adstdevlopment/Robot_Control_Board/Pictures/I2C pull-up resistor formula.PNG

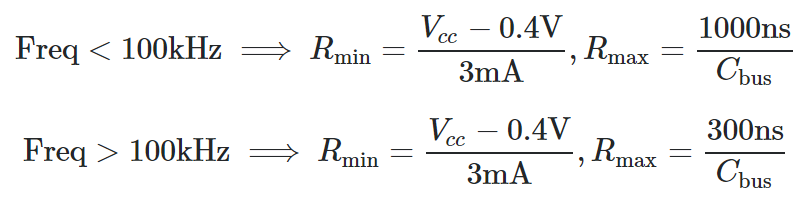
Pictures/I2C pull-up resistor formula.PNG
