adstdevlopment/Robot_Control_Board/Pictures/Impedance calculation USB.PNG

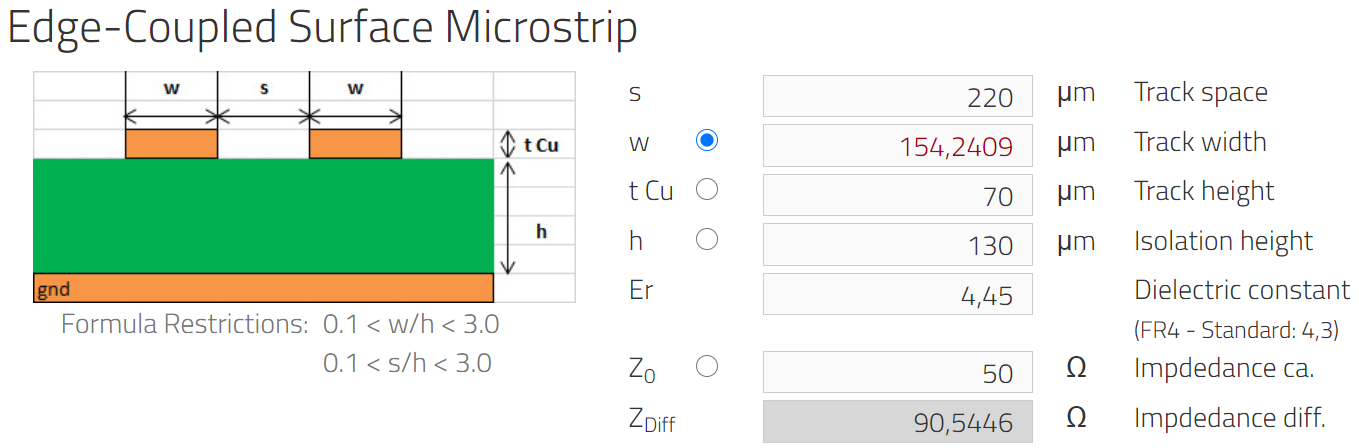
Pictures/Impedance calculation USB.PNG
