adstdevlopment/Robot_Control_Board/Pictures/Layers manager.PNG

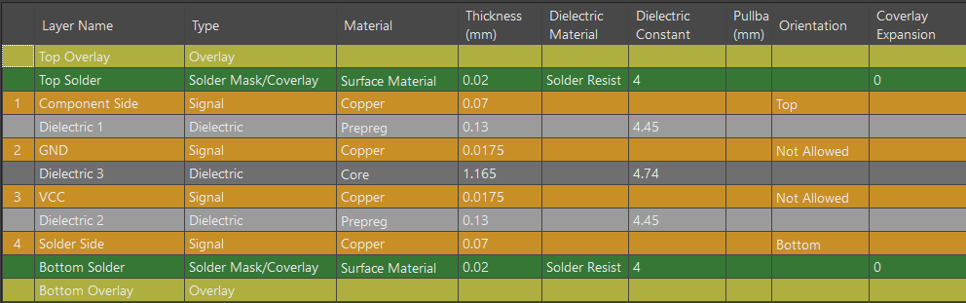
Pictures/Layers manager.PNG
