adstdevlopment/Robot_Control_Board/Pictures/PCB 4 layers sgn1_gnd_vcc_sgn2.PNG

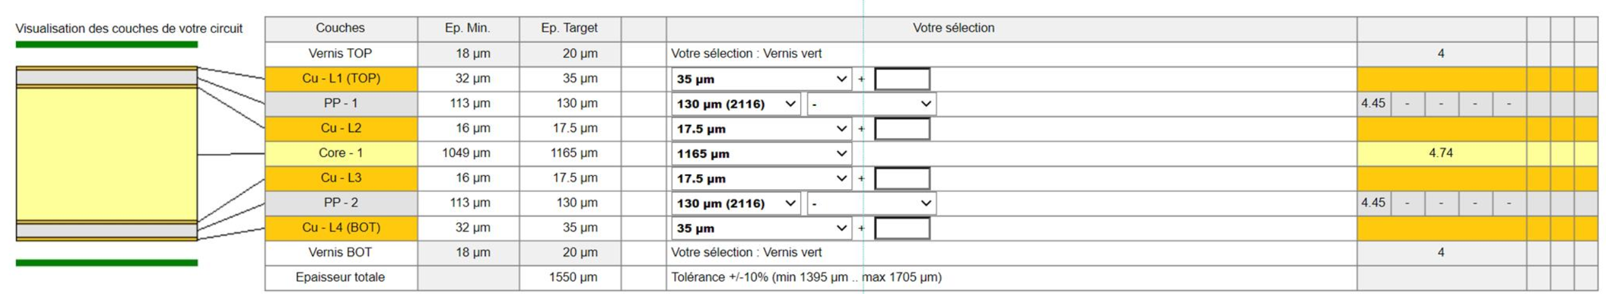
Pictures/PCB 4 layers sgn1_gnd_vcc_sgn2.PNG
