adstdevlopment/Robot_Control_Board/Pictures/Summary Table of the calculated values around shunt resistors.PNG

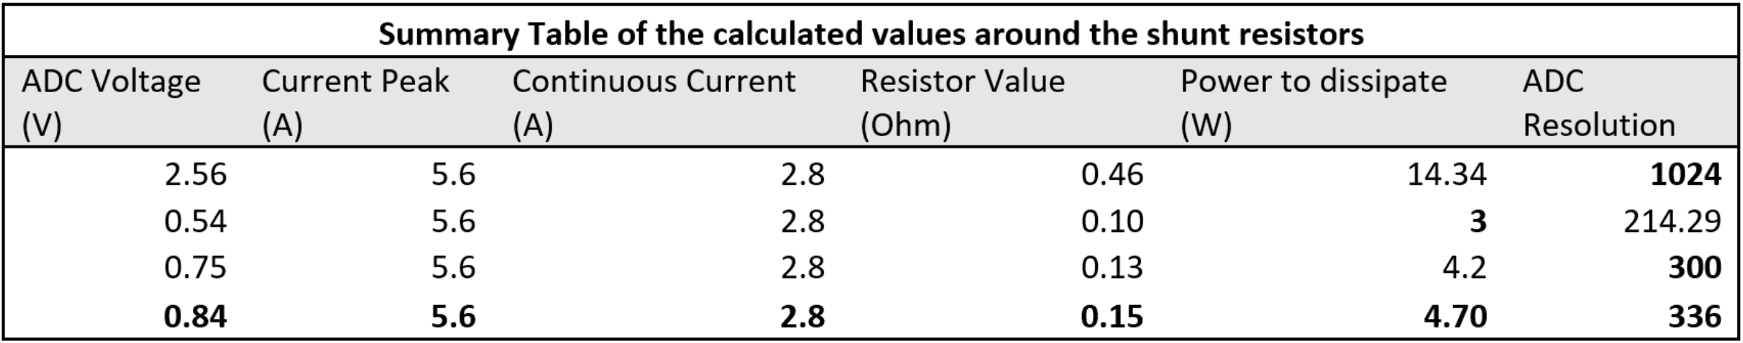
Pictures/Summary Table of the calculated values around shunt resistors.PNG
