adstdevlopment/Robot_Control_Board/Pictures/Truth table H-bridge.PNG

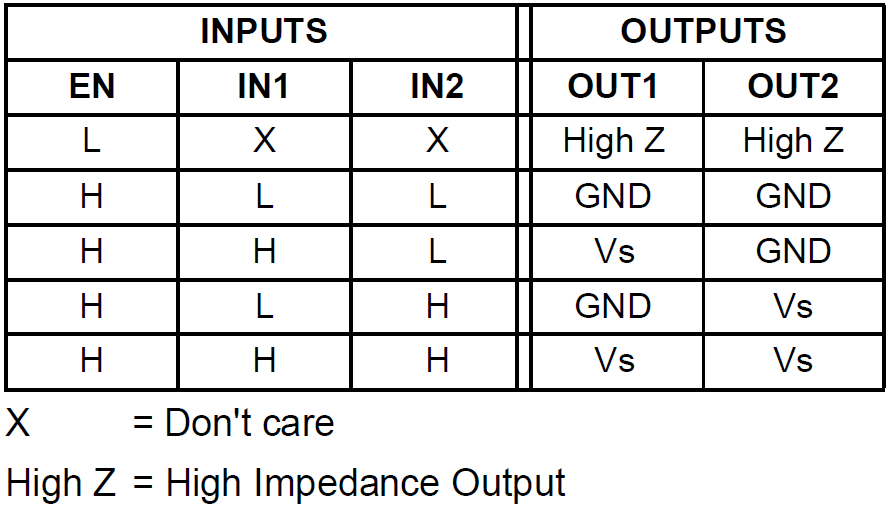
Pictures/Truth table H-bridge.PNG
