adstdevlopment/Robot_Control_Board/Pictures/VCC plan.PNG

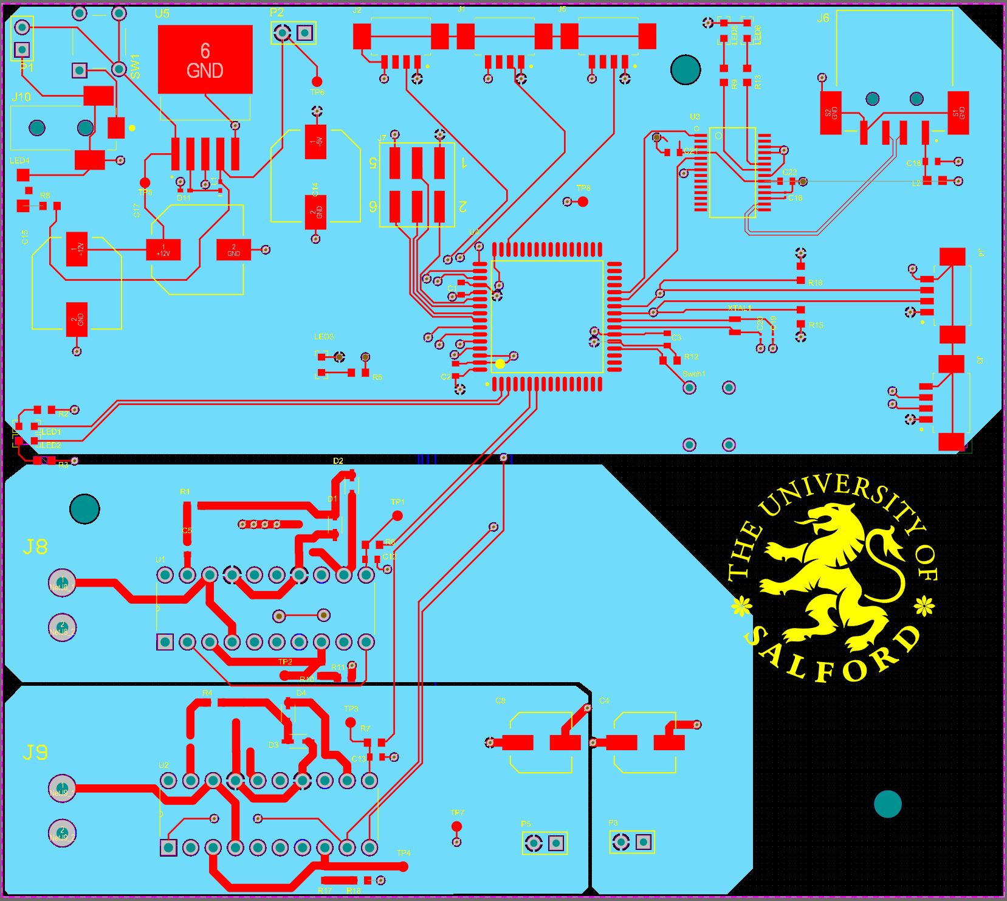
Pictures/VCC plan.PNG
