adstdevlopment/Robot_Control_Board/Pictures/Working approach to design a PCB.PNG

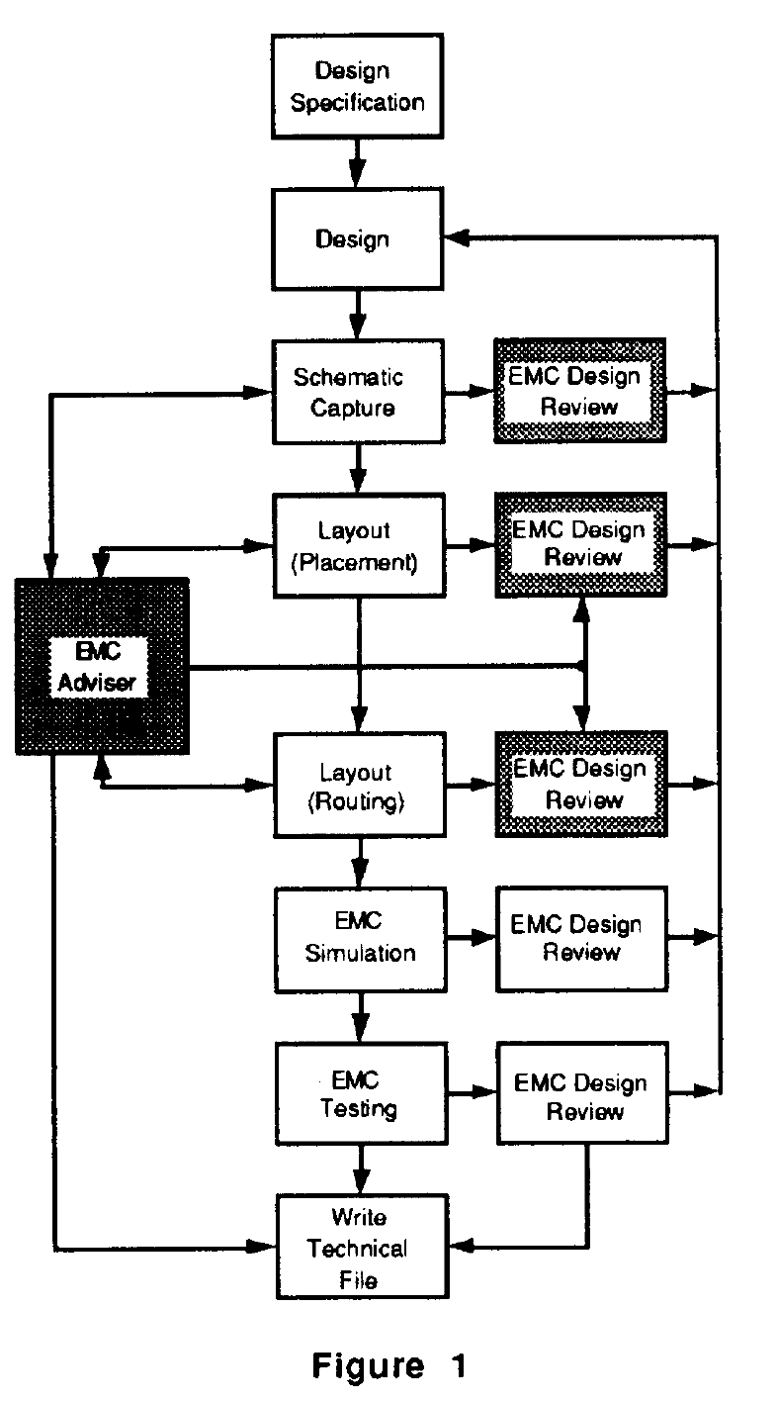
Pictures/Working approach to design a PCB.PNG
