adstdevlopment/Robot_Control_Board/(list of files, drawings)

Other design files:
Interface.SchDoc
Micro-Controller Unit.SchDoc
Motor Driver Unit.SchDoc
Power Supply Unit.SchDoc
Robot Control Board - save.PcbDoc
Salford Assignement21.PrjPcb
USB Control Unit.SchDoc
